jenshackel/RC-DiveMaster/images/Divemaster_Image_2.jpeg

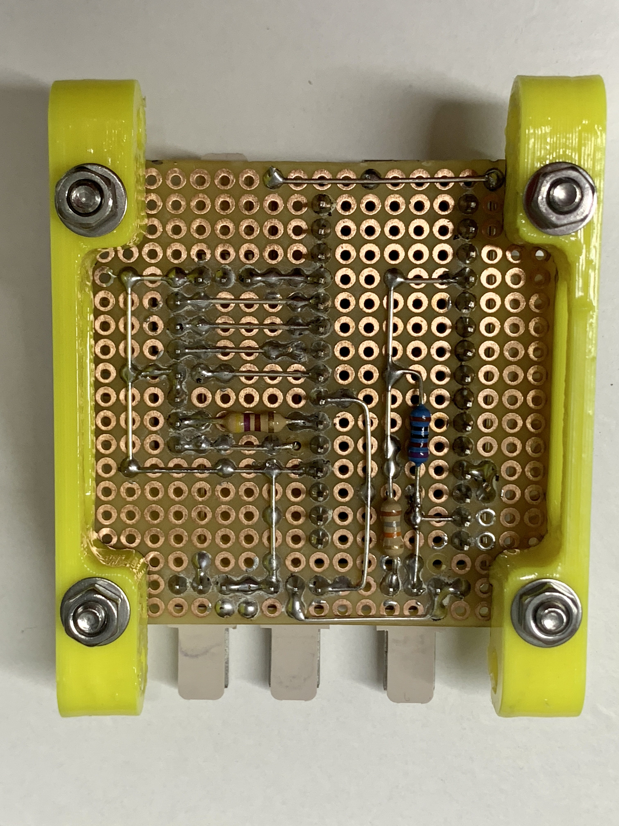
images/Divemaster_Image_2.jpeg
