jenshackel/RC-DiveMaster/images/RC-Divemaster.pdf

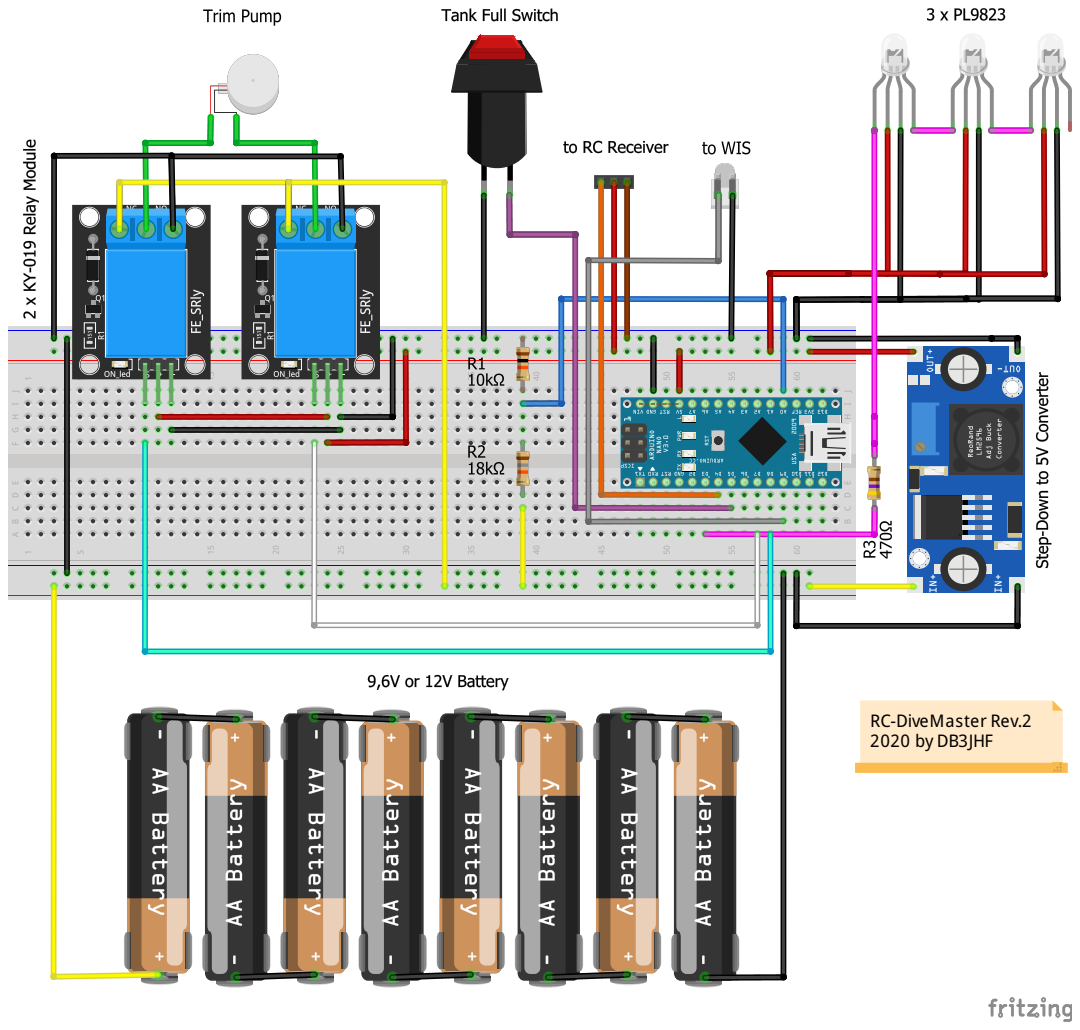
[picture p5: page 1]

RC-DiveMaster Rev.2
2020 by DB3JHF
