jenshackel/RC-DiveMaster/(commit log)

2020-10-28 Add files via upload
    Updated pictures with resistor R3 added.
2020-10-28 Delete RC-Divemaster.svg
    Old version, resistor R3 missing.
2020-10-28 Delete RC-Divemaster_Steckplatine.pdf
    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
2020-11-09 Add files via upload
    Corrected +5V Connection of Arduino
2020-11-15 Update RC-DiveMaster_Rev0.ino
    Activated internal pull-up resistors for input pins of WIS and tank full switch.
2020-11-16 Add files via upload
    Added image of WIS-Sensor for metric tube.
2020-11-19 Add files via upload
    - Corrected Timer fuction for emergency tank drain
    - If once triggered LED status for WIS or Bat.-Low. now remains (sporadic errors included)
    [DiveMaster_RC_Rev1.ino]
